jonbackflip/STM32-RFID-Based-Minecraft-Jukebox/PCB_Images/Bottom_Angled.png

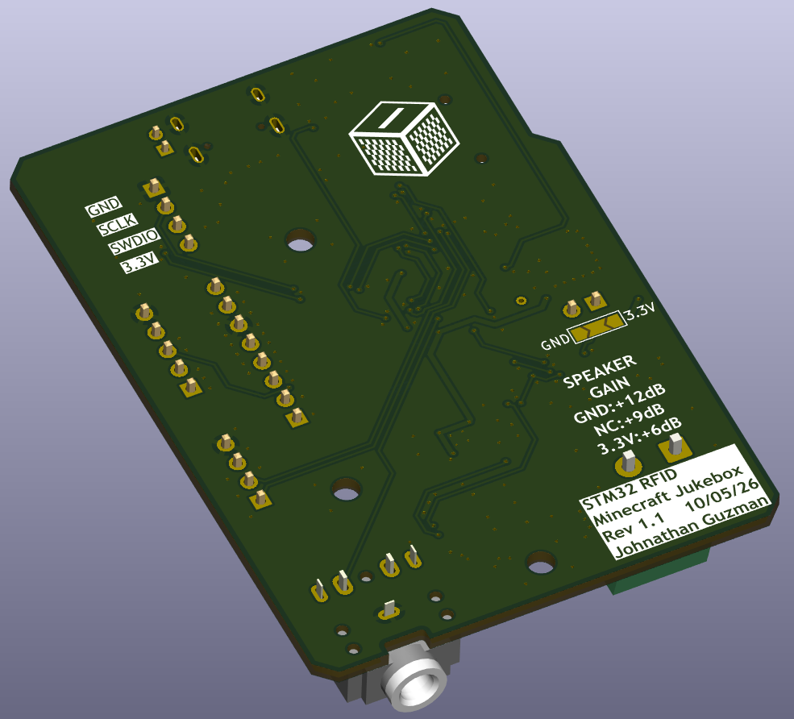
PCB_Images/Bottom_Angled.png
