jonbackflip/STM32-RFID-Based-Minecraft-Jukebox/PCB_Images/Top_Angled.png

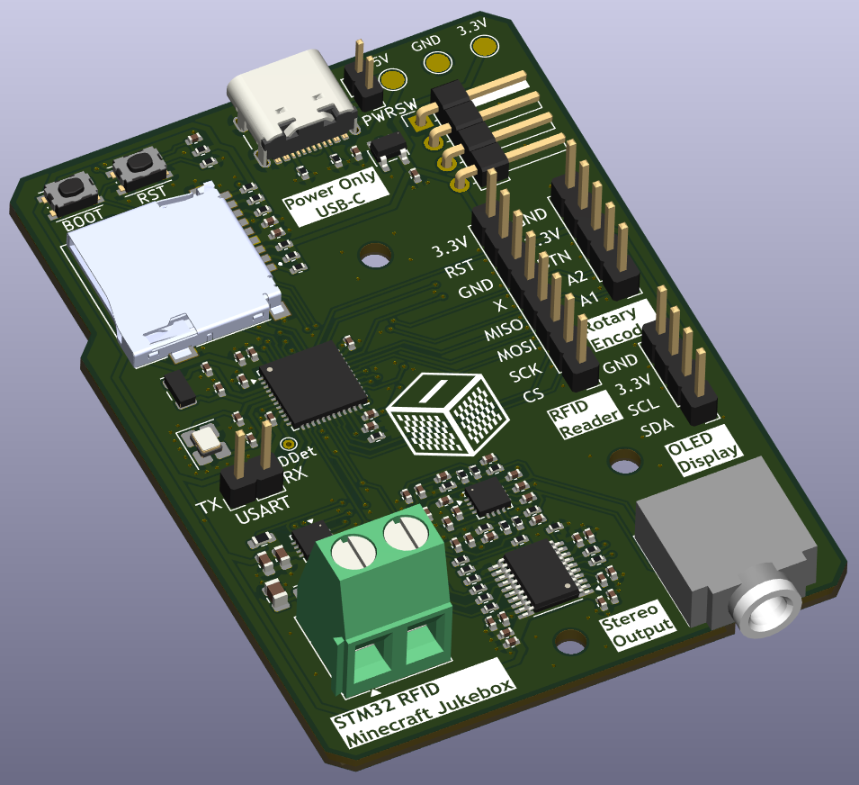
PCB_Images/Top_Angled.png
