jonbackflip/STM32-RFID-Based-Minecraft-Jukebox/README.md

# STM32-RFID-Based-Minecraft-Jukebox
An embedded music player based on the Minecraft Jukebox. Designed around an STM32F411CEU6, integrating RFID-based song selection, microSD storage, digital audio, user control via a rotary encoder with push-button, OLED display, and speaker/headphone output.
