jonbackflip/STM32-RFID-Based-Minecraft-Jukebox/PCB_Images/Bottom.png

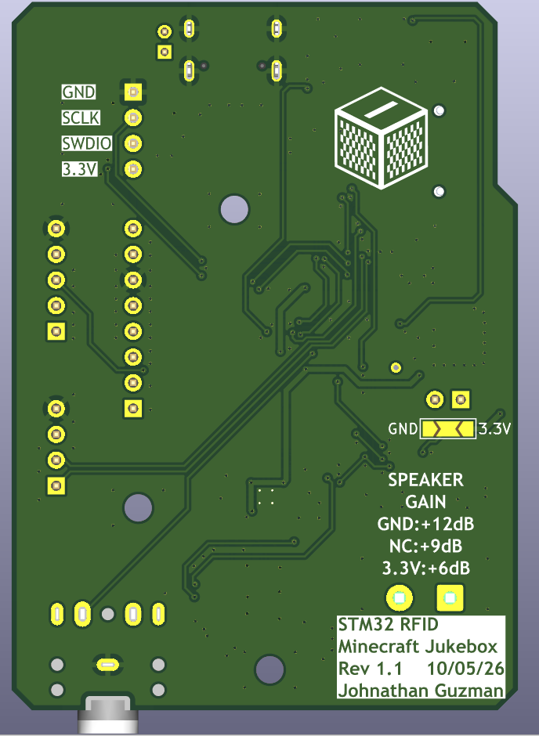
PCB_Images/Bottom.png
