jonbackflip/STM32-RFID-Based-Minecraft-Jukebox/PCB_Images/L1.png

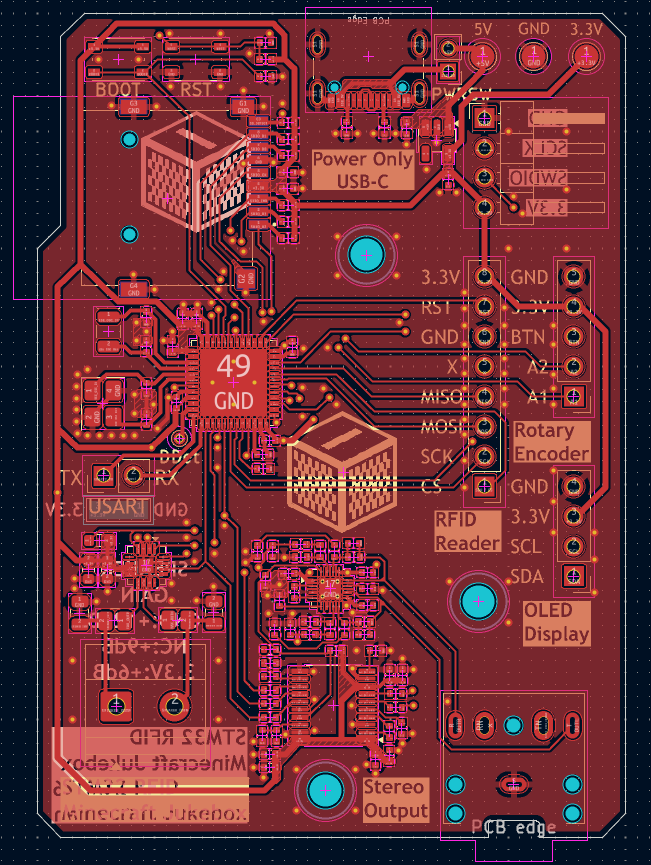
PCB_Images/L1.png
