jonbackflip/STM32-RFID-Based-Minecraft-Jukebox/PCB_Images/L2.png

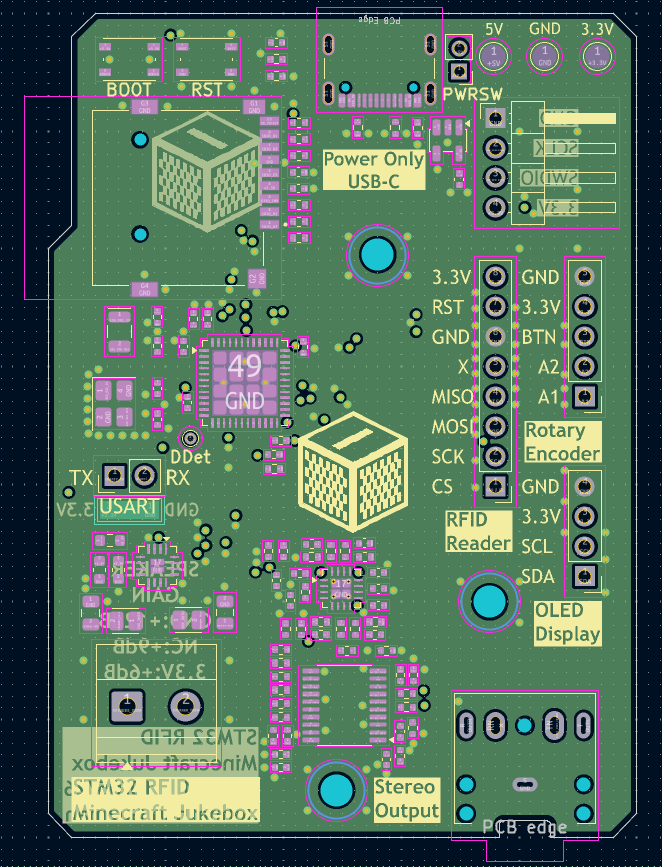
PCB_Images/L2.png
