jonbackflip/STM32-RFID-Based-Minecraft-Jukebox/PCB_Images/L3.png

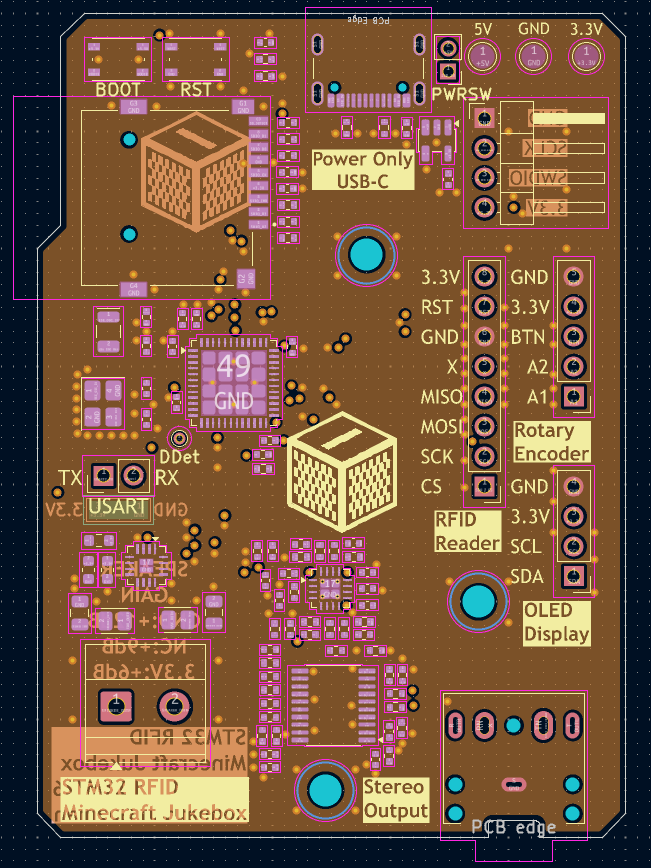
PCB_Images/L3.png
