jonbackflip/STM32-RFID-Based-Minecraft-Jukebox/PCB_Images/L4.png

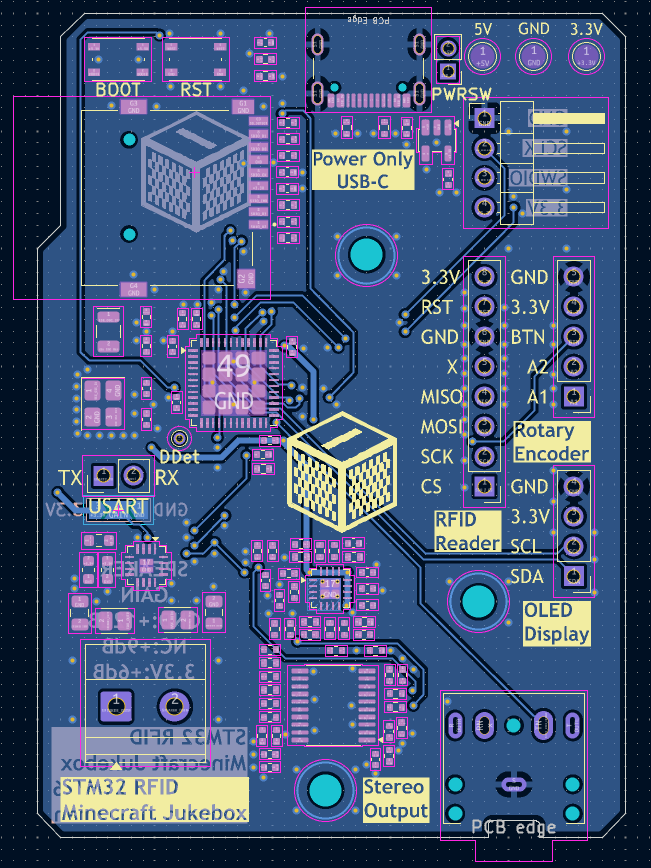
PCB_Images/L4.png
