jonbackflip/STM32-RFID-Based-Minecraft-Jukebox/PCB_Images/Top.png

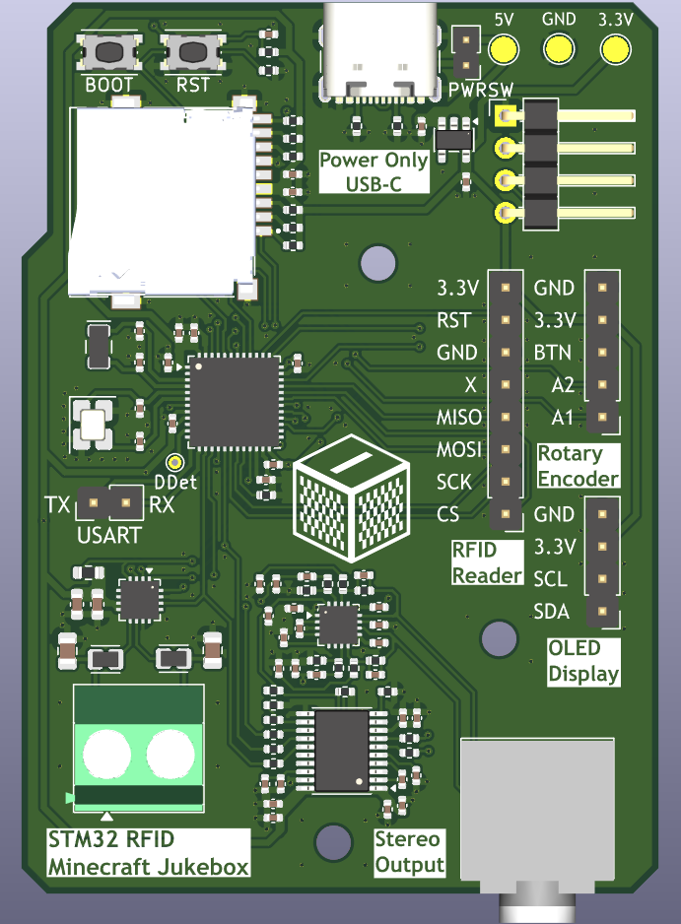
PCB_Images/Top.png
