jonbackflip/STM32-RFID-Based-Minecraft-Jukebox/Schematic_Images/Headphone DAC and Amplifier.png

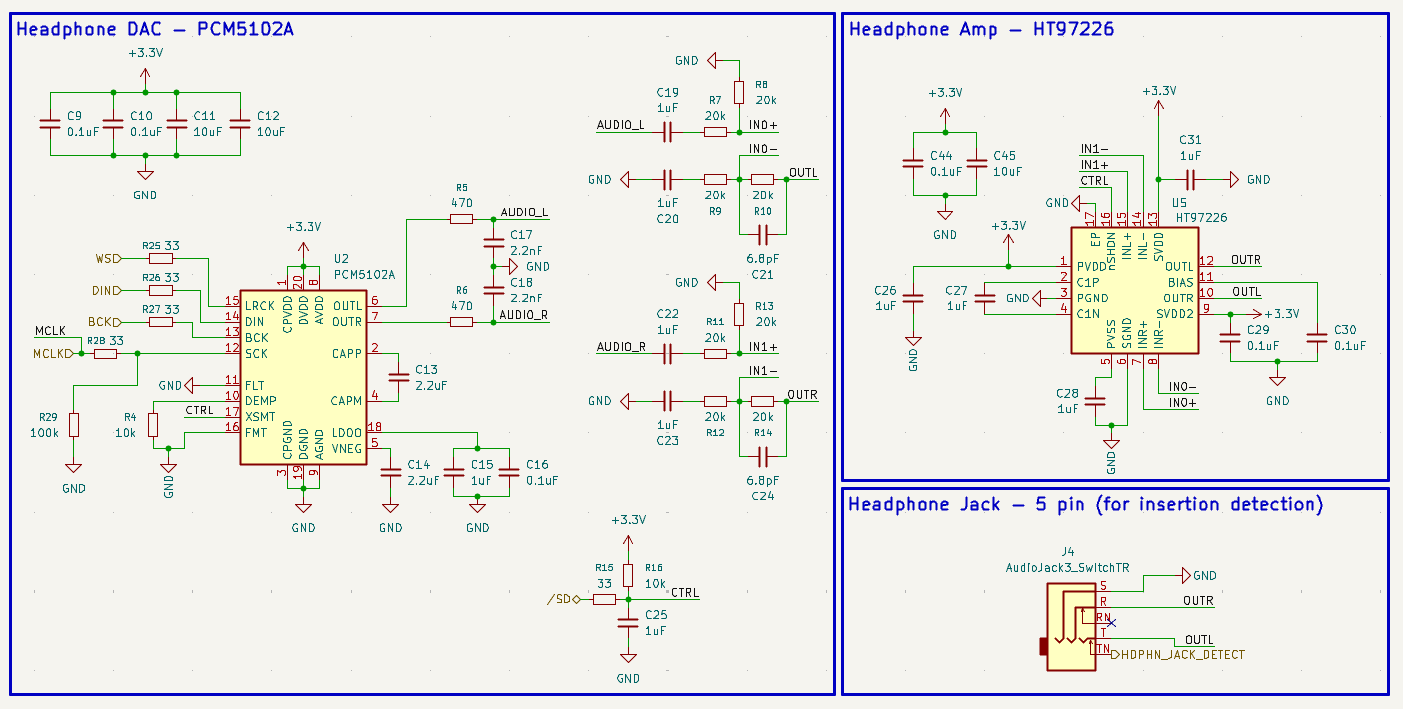
Schematic_Images/Headphone DAC and Amplifier.png
