jonbackflip/STM32-RFID-Based-Minecraft-Jukebox/Schematic_Images/High-Level Overview.png

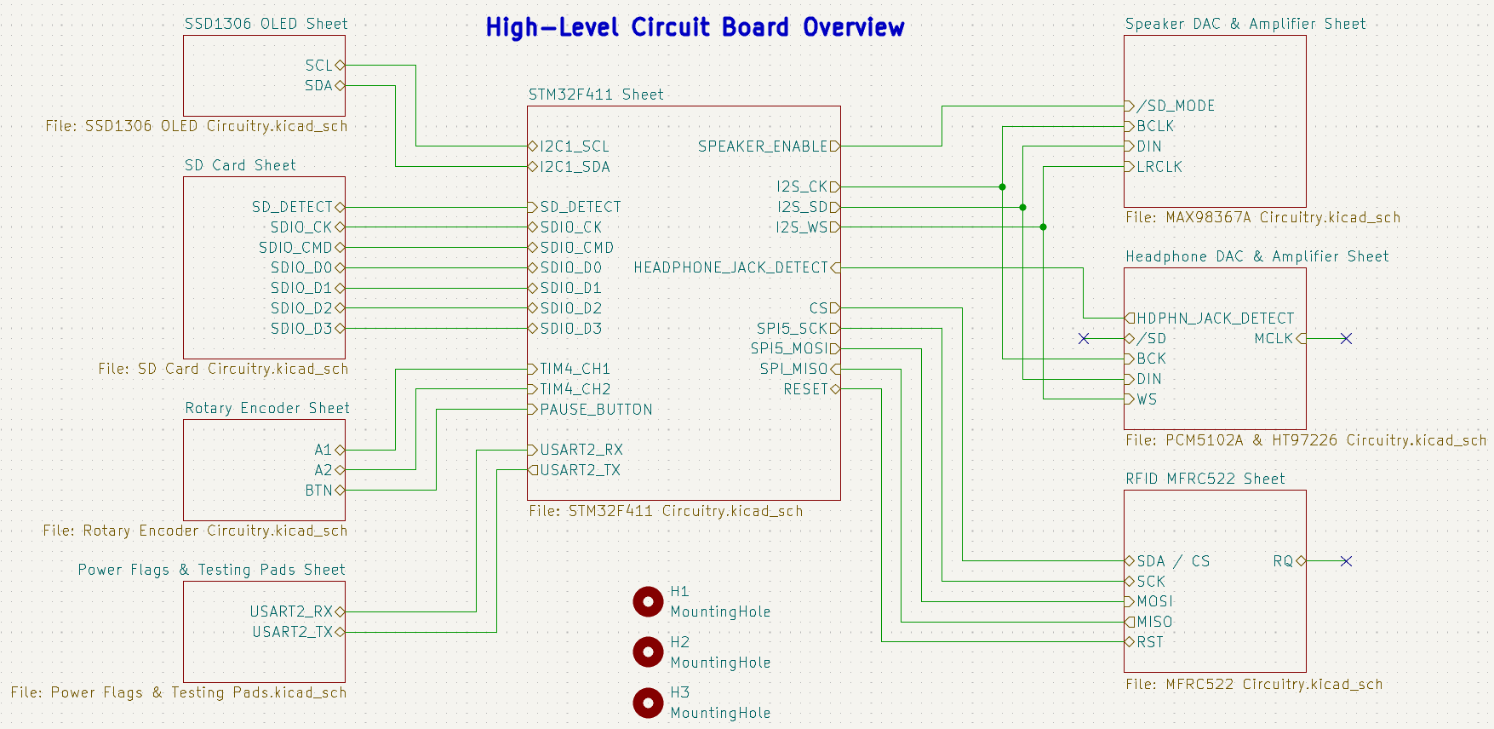
Schematic_Images/High-Level Overview.png
