jonbackflip/STM32-RFID-Based-Minecraft-Jukebox/Schematic_Images/MFRC522 RFID Reader.png

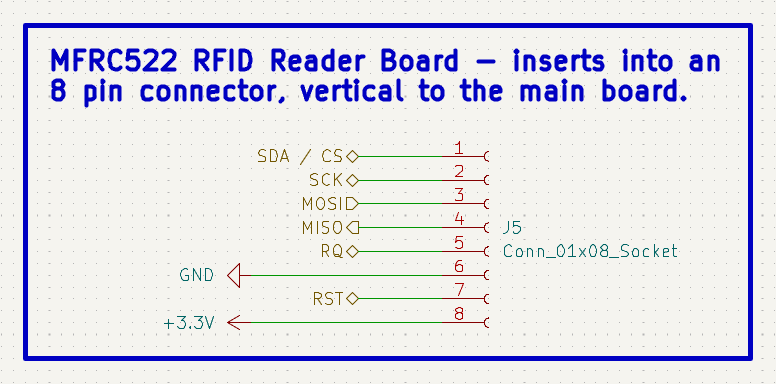
Schematic_Images/MFRC522 RFID Reader.png
