jonbackflip/STM32-RFID-Based-Minecraft-Jukebox/Schematic_Images/MicroSD Card.png

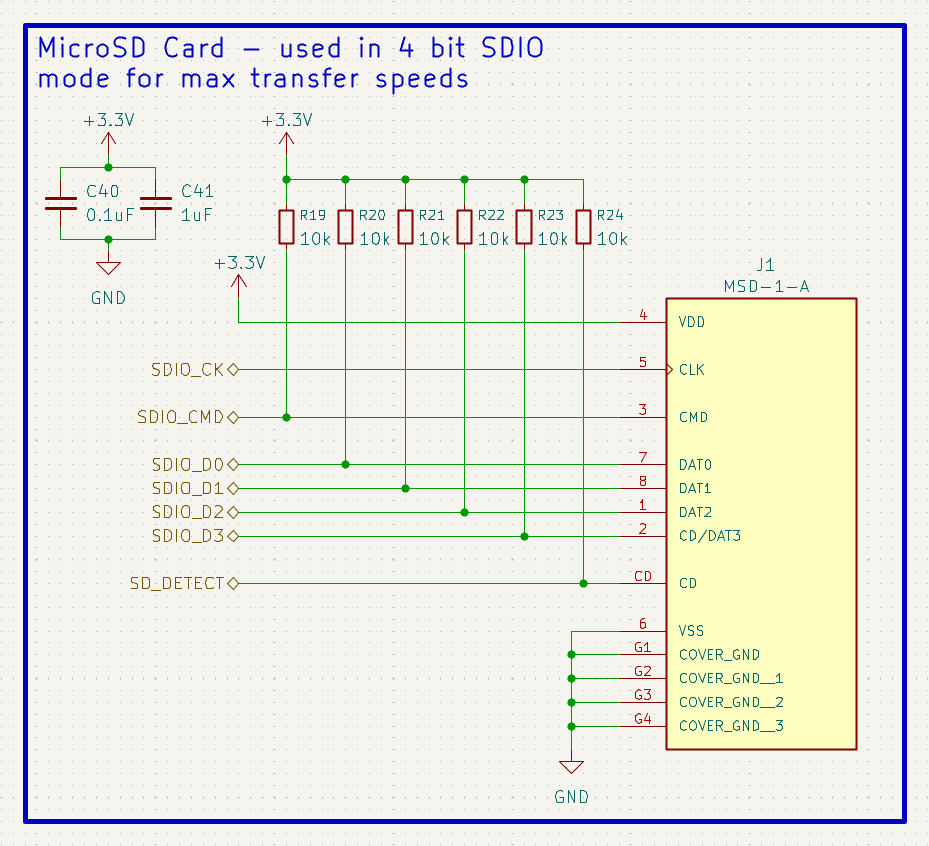
Schematic_Images/MicroSD Card.png
