jonbackflip/STM32-RFID-Based-Minecraft-Jukebox/Schematic_Images/Rotary Encoder.png

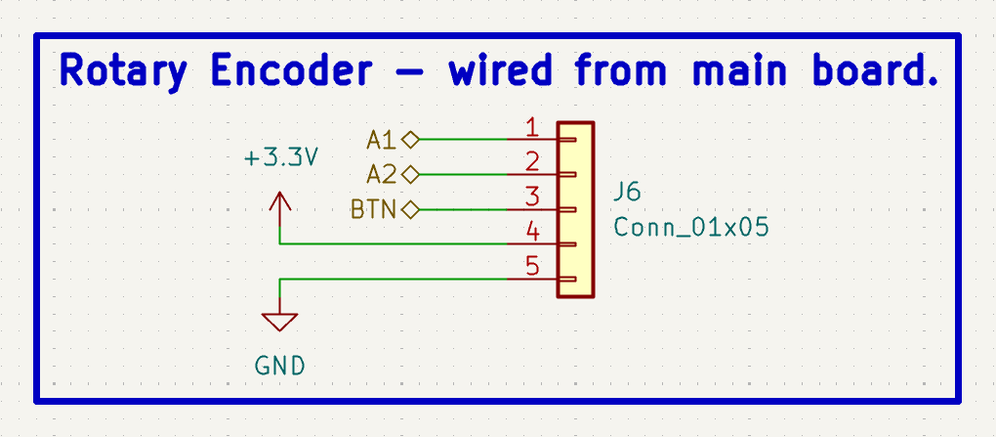
Schematic_Images/Rotary Encoder.png
