jonbackflip/STM32-RFID-Based-Minecraft-Jukebox/Schematic_Images/Speaker DAC and Amplifier.png

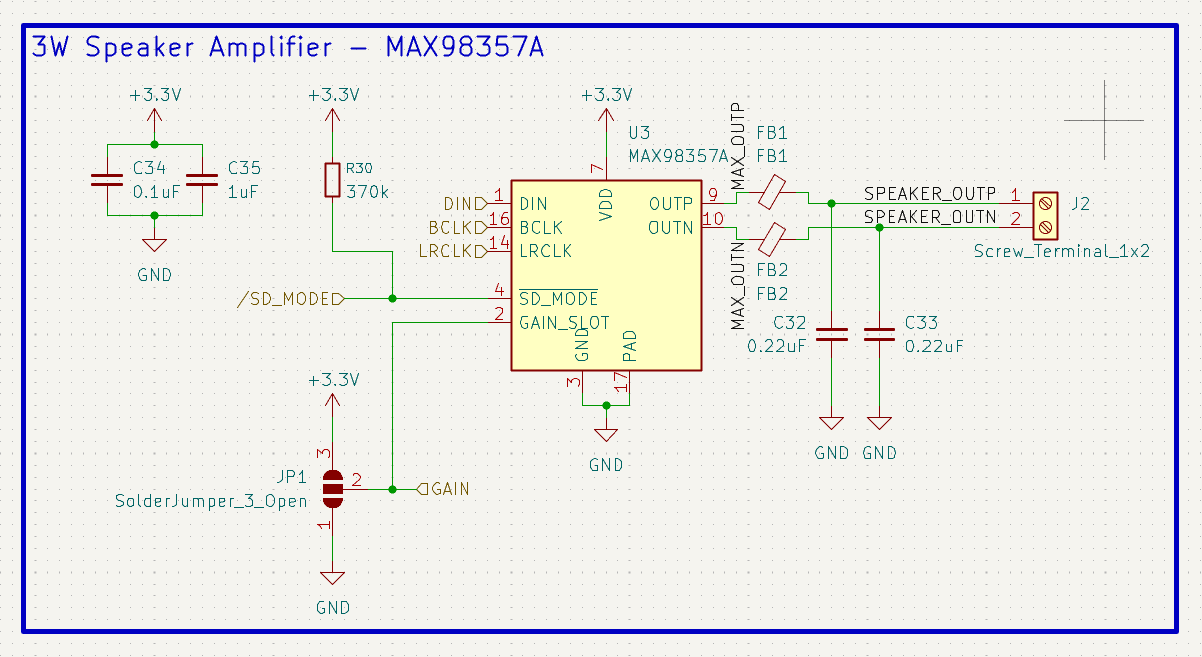
Schematic_Images/Speaker DAC and Amplifier.png
