jonbackflip/STM32-RFID-Based-Minecraft-Jukebox/Schematic_Images/SSD1306 OLED.png

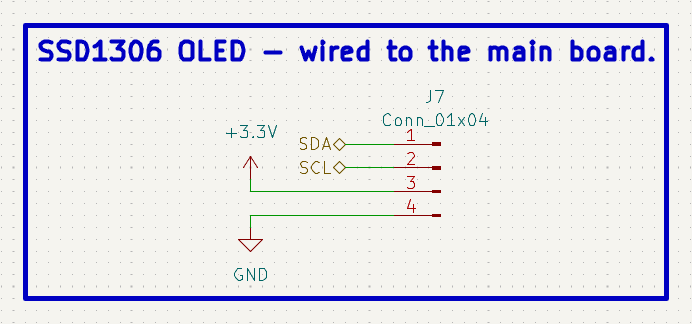
Schematic_Images/SSD1306 OLED.png
