jonbackflip/STM32-RFID-Based-Minecraft-Jukebox/Schematic_Images/STM32F411.png

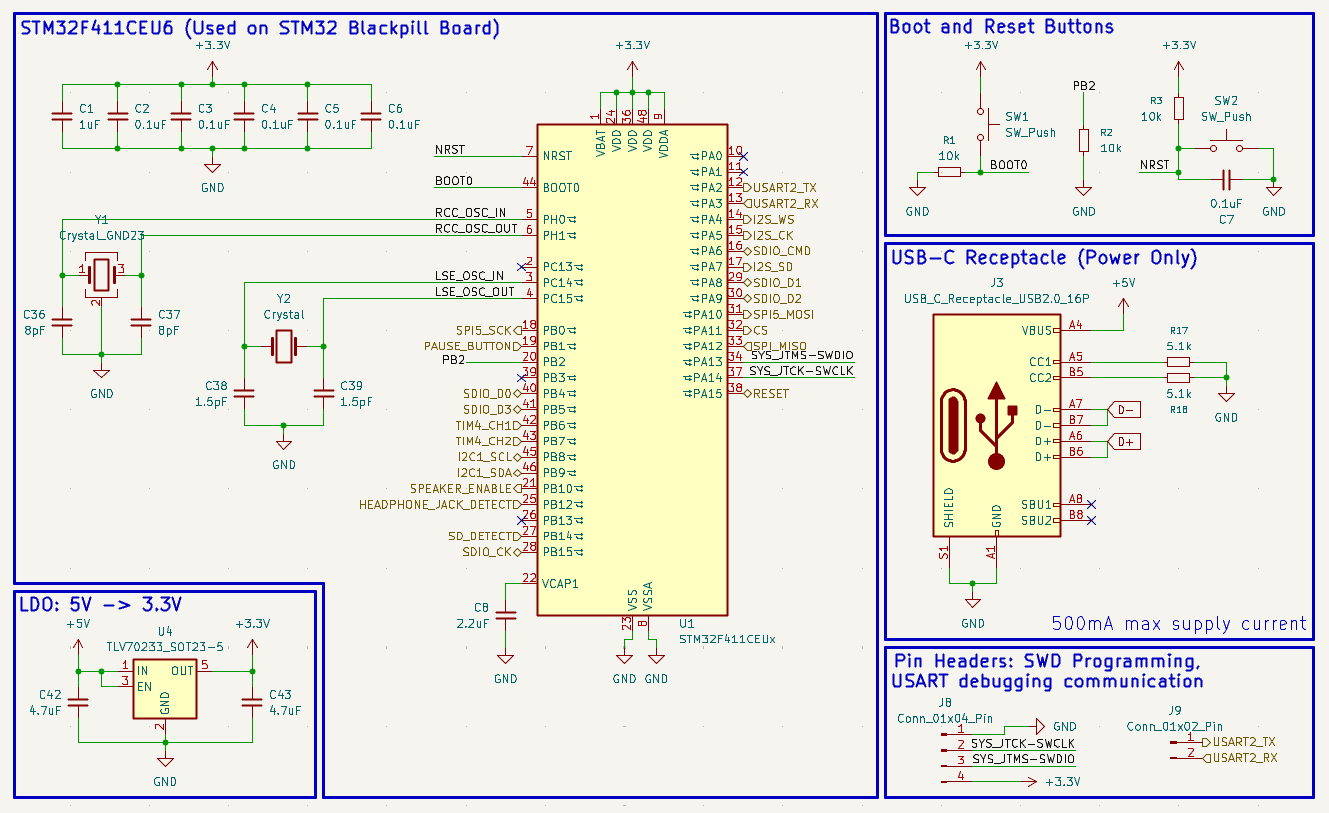
Schematic_Images/STM32F411.png
