jonbackflip/STM32-RFID-Based-Minecraft-Jukebox/Schematic_Images/Power Flags and Testing Points.png

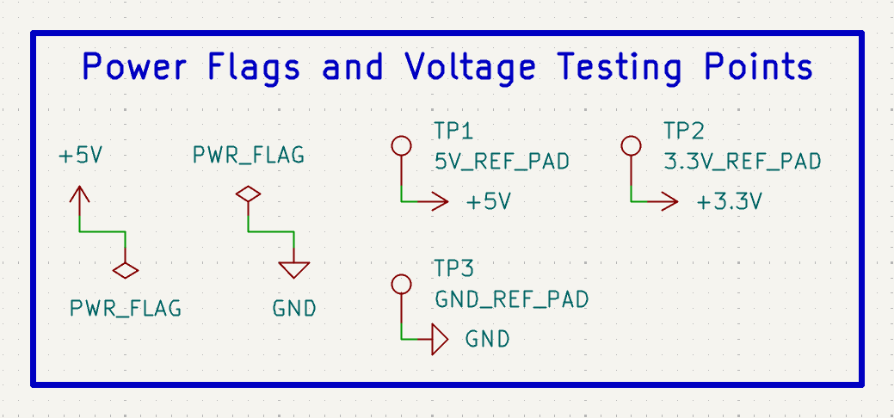
Schematic_Images/Power Flags and Testing Points.png
