jonbackflip/STM32-RFID-Based-Minecraft-Jukebox/STM32JukeboxPCB.kicad_pcb

## KiCad design STM32JukeboxPCB.kicad_pcb (2026-10-05)

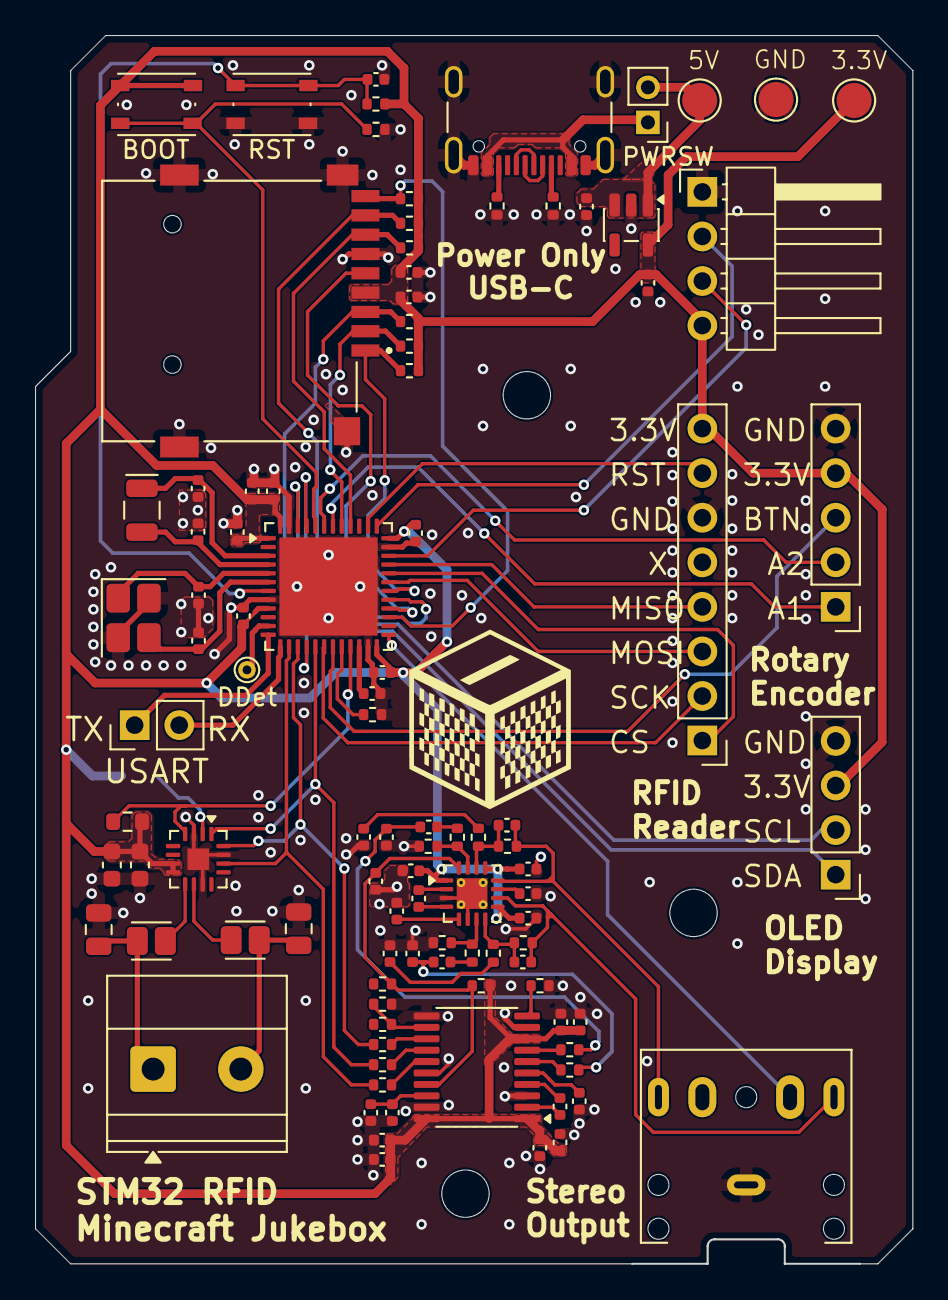
[picture p19: board STM32JukeboxPCB.kicad_pcb from above]

Board: 4 copper layers, 50.0 x 70.0 mm, 104 parts (1 on the bottom side), 76 nets.

Parts:
C1, C15, C19, C20, C22, C23, C25, C26, C27, C28, C31, C41: 1uF; C_0402_1005Metric
C2, C3, C4, C5, C6, C7, C9, C10, C16, C29, C30, C40, C44: 0.1uF; C_0402_1005Metric
C8, C13, C14: 2.2uF; C_0402_1005Metric
C11, C12, C45: 10uF; C_0402_1005Metric
C17, C18: 2.2nF; C_0402_1005Metric
C21, C24: 6.8pF; C_0402_1005Metric
C32, C33: 0.22uF; C_0805_2012Metric
C34: 0.1uF; C_0603_1608Metric
C35: 1uF; C_0603_1608Metric
C36, C37: 8pF; C_0402_1005Metric
C38, C39: 1.5pF; C_0402_1005Metric
C42, C43: 4.7uF; C_0402_1005Metric
DDet: Conn_1x1; TestPoint_THTPad_D1.0mm_Drill0.5mm
FB1: FB1; L_Eaton_MCL2012V1
FB2: FB2; L_Eaton_MCL2012V1
H1, H2, H3: MountingHole; MountingHole_2.7mm_M2.5_DIN965
J1: MSD-1-A; CUI_MSD-1-A
J2: Screw_Terminal_1x2; TerminalBlock_Phoenix_MKDS-1,5-2_1x02_P5.00mm_Horizontal
J3: USB_C_Receptacle_USB2.0_16P; USB_C_Receptacle_GCT_USB4105-xx-A_16P_TopMnt_Horizontal
J4: AudioJack3_SwitchTR; Jack_3.5mm_CUI_SJ1-3525N_Horizontal
J5: Conn_01x08_Socket; PinHeader_1x08_P2.54mm_Vertical
J6: Conn_01x05; PinHeader_1x05_P2.54mm_Vertical
J7: Conn_01x04; PinHeader_1x04_P2.54mm_Vertical
J8: Conn_01x04_Pin; PinHeader_1x04_P2.54mm_Horizontal
J9: Conn_01x02_Pin; PinHeader_1x02_P2.54mm_Vertical
JP1: SolderJumper_3_Open; SolderJumper-3_P2.0mm_Open_TrianglePad1.0x1.5mm_NumberLabels
PWRSW: SW_SPST; PinHeader_1x02_P2.00mm_Vertical
R1, R2, R3, R4, R16, R19, R20, R21, R22, R23, R24: 10k; R_0402_1005Metric
R5, R6: 470; R_0402_1005Metric
R7, R8, R9, R10, R11, R12, R13, R14: 20k; R_0402_1005Metric
R15, R25, R26, R27, R28: 33; R_0402_1005Metric
R17, R18: 5.1k; R_0402_1005Metric
R29: 100k; R_0402_1005Metric
R30: 370k; R_0603_1608Metric
SW1, SW2: SW_Push; SW_Push_1P1T_NO_Vertical_Wuerth_434133025816
TP1: 5V_REF_PAD; TestPoint_Pad_D2.0mm
TP2: 3.3V_REF_PAD; TestPoint_Pad_D2.0mm
TP3: GND_REF_PAD; TestPoint_Pad_D2.0mm
U1: STM32F411CEUx; QFN-48-1EP_7x7mm_P0.5mm_EP5.6x5.6mm
U2: PCM5102A; TSSOP-20_4.4x6.5mm_P0.65mm
U3: MAX98357A; TQFN-16-1EP_3x3mm_P0.5mm_EP1.23x1.23mm
U4: TLV70233_SOT23-5; SOT-23-5
U5: HT97226; QFN-16-1EP_3x3mm_P0.5mm_EP1.75x1.75mm_ThermalVias
Y1: Crystal_GND23; Oscillator_SMD_SeikoEpson_SG210-4Pin_2.5x2.0mm_HandSoldering
Y2: Crystal; Crystal_SMD_MicroCrystal_CC7V-T1A-2Pin_3.2x1.5mm

Connections:
+3.3V: C1.1, C2.1, C3.1, C4.1, C5.1, C6.1, C9.1, C10.1, C11.1, C12.1, C26.1, C29.1, C31.1, C34.1, C35.2, C40.1, C41.2, C43.1, C44.1, C45.1, J1.4 (VDD), J5.8, J6.4, J7.3, J8.4, JP1.3 (B), R3.2, R16.1, R19.2, R20.2, R21.2, R22.2, R23.2, R24.2, R30.2, SW1.1, TP2.1 (1_1), U1.1 (VBAT), U1.9 (VDDA), U1.24 (VDD), U1.36 (VDD), U1.48 (VDD), U2.1 (CPVDD), U2.8 (AVDD), U2.20 (DVDD), U3.7 (VDD), U3.8 (VDD), U4.5 (OUT), U5.1 (PVDD), U5.9 (SVDD2), U5.13 (SVDD)
+5V: C42.1, PWRSW.2 (B), TP1.1 (1_1), U4.1 (IN), U4.3 (EN)
/Headphone DAC & Amplifier Sheet/AUDIO_L: C17.1, C19.1, R5.1
/Headphone DAC & Amplifier Sheet/AUDIO_R: C18.2, C22.1, R6.1
/Headphone DAC & Amplifier Sheet/BCK: R27.2, U1.15 (PA5), U3.16 (BCLK)
/Headphone DAC & Amplifier Sheet/CTRL: C25.1, R15.1, R16.2, U2.17 (XSMT), U5.16 (nSHDN)
/Headphone DAC & Amplifier Sheet/DIN: R26.2, U1.17 (PA7), U3.1 (DIN)
/Headphone DAC & Amplifier Sheet/HDPHN_JACK_DETECT: J4.TN, U1.25 (PB12)
/Headphone DAC & Amplifier Sheet/IN0+: R7.1, R8.2, U5.7 (INR+)
/Headphone DAC & Amplifier Sheet/IN0-: C21.1, R9.1, R10.2, U5.8 (INR-)
/Headphone DAC & Amplifier Sheet/IN1+: R11.1, R13.2, U5.15 (INL+)
/Headphone DAC & Amplifier Sheet/IN1-: C24.1, R12.1, R14.2, U5.14 (INL-)
/Headphone DAC & Amplifier Sheet/OUTL: C21.2, J4.T, R10.1, U5.10 (OUTR)
/Headphone DAC & Amplifier Sheet/OUTR: C24.2, J4.R, R14.1, U5.12 (OUTL)
/Headphone DAC & Amplifier Sheet/WS: R25.2, U1.14 (PA4), U3.14 (LRCLK)
/RFID MFRC522 Sheet/MISO: J5.4, U1.33 (PA12)
/RFID MFRC522 Sheet/MOSI: J5.3, U1.31 (PA10)
/RFID MFRC522 Sheet/RST: J5.7, U1.38 (PA15)
/RFID MFRC522 Sheet/SCK: J5.2, U1.18 (PB0)
/RFID MFRC522 Sheet/SDA / CS: J5.1, U1.32 (PA11)
/Rotary Encoder Sheet/A1: J6.1, U1.42 (PB6)
/Rotary Encoder Sheet/A2: J6.2, U1.43 (PB7)
/Rotary Encoder Sheet/BTN: J6.3, U1.19 (PB1)
/SD Card Sheet/SDIO_CK: J1.5 (CLK), U1.28 (PB15)
/SD Card Sheet/SDIO_CMD: J1.3 (CMD), R19.1, U1.16 (PA6)
/SD Card Sheet/SDIO_D0: J1.7 (DAT0), R20.1, U1.40 (PB4)
/SD Card Sheet/SDIO_D1: J1.8 (DAT1), R21.1, U1.29 (PA8)
/SD Card Sheet/SDIO_D2: J1.1 (DAT2), R22.1, U1.30 (PA9)
/SD Card Sheet/SDIO_D3: J1.2 (CD/DAT3), R23.1, U1.41 (PB5)
/SD Card Sheet/SD_DETECT: J1.CD, R24.1, U1.27 (PB14)
/SSD1306 OLED Sheet/SCL: J7.2, U1.45 (PB8)
/SSD1306 OLED Sheet/SDA: J7.1, U1.46 (PB9)
/STM32F411 Sheet/BOOT0: R1.2, SW1.2, U1.44 (BOOT0)
/STM32F411 Sheet/Insert_Disc_Detect: DDet.1 (Pin_1_1), U1.11 (PA1)
/STM32F411 Sheet/LSE_OSC_IN: C38.1, U1.3 (PC14), Y2.1
/STM32F411 Sheet/LSE_OSC_OUT: C39.1, U1.4 (PC15), Y2.2
/STM32F411 Sheet/NRST: C7.1, R3.1, SW2.1, U1.7 (NRST)
/STM32F411 Sheet/PB2: R2.2, U1.20 (PB2)
/STM32F411 Sheet/RCC_OSC_IN: C36.1, U1.5 (PH0), Y1.1
/STM32F411 Sheet/RCC_OSC_OUT: C37.1, U1.6 (PH1), Y1.3
/STM32F411 Sheet/SPEAKER_ENABLE: R30.1, U1.21 (PB10), U3.4 (~SD_MODE)
/STM32F411 Sheet/SYS_JTCK-SWCLK: J8.2, U1.37 (PA14)
/STM32F411 Sheet/SYS_JTMS-SWDIO: J8.3, U1.34 (PA13)
/STM32F411 Sheet/USART2_RX: J9.2, U1.13 (PA3)
/STM32F411 Sheet/USART2_TX: J9.1, U1.12 (PA2)
/STM32F411 Sheet/USB_5V: J3.A4 (VBUS), J3.A9 (VBUS), J3.B4 (VBUS), J3.B9 (VBUS), PWRSW.1 (A)
/Speaker DAC & Amplifier Sheet/GAIN: JP1.2 (C), U3.2 (GAIN_SLOT)
/Speaker DAC & Amplifier Sheet/MAX_OUTN: FB2.1, U3.10 (OUTN)
/Speaker DAC & Amplifier Sheet/MAX_OUTP: FB1.1, U3.9 (OUTP)
/Speaker DAC & Amplifier Sheet/SPEAKER_OUTN: C33.1, FB2.2, J2.2
/Speaker DAC & Amplifier Sheet/SPEAKER_OUTP: C32.2, FB1.2, J2.1
D+: J3.A6 (D+), J3.B6 (D+)
D-: J3.A7 (D-), J3.B7 (D-)
GND: C1.2, C2.2, C3.2, C4.2, C5.2, C6.2, C7.2, C8.2, C9.2, C10.2, C11.2, C12.2, C14.2, C15.2, C16.2, C17.2, C18.1, C20.1, C23.1, C25.2, C26.2, C28.2, C29.2, C30.2, C31.2, C32.1, C33.2, C34.2, C35.1, C36.2, C37.2, C38.2, C39.2, C40.2, C41.1, C42.2, C43.2, C44.2, C45.2, J1.6 (VSS), J1.G1 (COVER_GND), J1.G2 (COVER_GND__1), J1.G3 (COVER_GND__2), J1.G4 (COVER_GND__3), J3.A1 (GND), J3.A12 (GND), J3.B1 (GND), J3.B12 (GND), J3.S1 (SHIELD), J4.S, J5.6, J6.5, J7.4, J8.1, JP1.1 (A), R1.1, R2.1, R4.1, R8.1, R13.1, R17.1, R18.1, R29.2, SW2.2, TP3.1 (1_1), U1.8 (VSSA), U1.23 (VSS), U1.35 (VSS), U1.47 (VSS), U1.49 (VSS), U2.3 (CPGND), U2.9 (AGND), U2.11 (FLT), U2.16 (FMT), U2.19 (DGND), U3.3 (GND), U3.11 (GND), U3.15 (GND), U3.17 (PAD), U4.2 (GND), U5.3 (PGND), U5.6 (SGND), U5.17 (EP), Y1.2 (G), Y1.4 (G)
unnamed: C19.2, R7.2
unnamed: C20.2, R9.2
unnamed: C22.2, R11.2
unnamed: C23.2, R12.2
unnamed: J3.A5 (CC1), R17.2
unnamed: J3.B5 (CC2), R18.2
unnamed: C8.1, U1.22 (VCAP1)
unnamed: R27.1, U2.13 (BCK)
unnamed: C13.2, U2.4 (CAPM)
unnamed: C13.1, U2.2 (CAPP)
unnamed: R4.2, U2.10 (DEMP)
unnamed: R26.1, U2.14 (DIN)
unnamed: C15.1, C16.1, U2.18 (LDOO)
unnamed: R25.1, U2.15 (LRCK)
unnamed: R5.2, U2.6 (OUTL)
unnamed: R6.2, U2.7 (OUTR)
unnamed: R28.1, R29.1, U2.12 (SCK)
unnamed: C14.1, U2.5 (VNEG)
unnamed: C30.1, U5.11 (BIAS)
unnamed: C27.2, U5.4 (C1N)
unnamed: C27.1, U5.2 (C1P)
unnamed: C28.1, U5.5 (PVSS)
