jonbackflip/STM32-RFID-Based-Minecraft-Jukebox/Jukebox_STM32CubeIDE_Files/Core/Src/main.c

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
/* Includes ------------------------------------------------------------------*/
#include "main.h"
#include "fatfs.h"

/* USER CODE BEGIN Includes */
#include <string.h>
#include "SSD1306Driver.h"
#include "MFRC522_STM32.h"
#include "WavPlayer.h"
/* USER CODE END Includes */

/* USER CODE BEGIN PD */

#define TAU 6.28318530717958647692

/* USER CODE END PD */

I2C_HandleTypeDef hi2c1;

I2S_HandleTypeDef hi2s1;
DMA_HandleTypeDef hdma_spi1_tx;

SD_HandleTypeDef hsd;
DMA_HandleTypeDef hdma_sdio;

SPI_HandleTypeDef hspi5;

TIM_HandleTypeDef htim1;
TIM_HandleTypeDef htim2;
TIM_HandleTypeDef htim4;

UART_HandleTypeDef huart2;

/* USER CODE BEGIN PV */

// ---- OLED redraw throttle (set by TIM2 ISR, checked once per main loop) --
volatile uint8_t oledNeedsRedraw = 0;

// ---- Idle-screen animation (jukebox icon + flashing arrow) --------------
// Toggled every TIM2 tick (250ms) -> 2Hz blinking rate
static volatile uint8_t arrowBlinkOn = 0;

// ---- RFID detection, triggered by the disc-press button on PA1 ----------
// The button's EXTI ISR only arms a burst -- it must NOT call
// MFRC522_RequestA() itself (each call can block tens of ms; 8 of them
// back-to-back inside an interrupt could stall I2S refills for most of
// a second). The main loop steps the burst one poll at a time, 100ms
// apart, same timing discipline as the old continuous TIM1 poll.
#define RFID_BURST_POLL_COUNT      4   // total polls per button press
#define RFID_BURST_CONFIRM_COUNT   1   // need at least this many "present" results
#define RFID_POLL_INTERVAL_MS      100 // spacing between polls within a burst
#define BUTTON_DEBOUNCE_MS         300 // ignore re-triggers faster than this

typedef enum { RFID_BURST_IDLE, RFID_BURST_ACTIVE } RfidBurstState_t;
static volatile RfidBurstState_t burstState = RFID_BURST_IDLE; // set by EXTI ISR, cleared by main loop
static uint32_t burstLastPollTime = 0;
static uint8_t  burstPollsRemaining = 0;
static uint8_t  burstGoodCount = 0;
static uint32_t lastButtonEventTime = 0;

typedef enum { DISC_ABSENT, DISC_PRESENT } DiscState_t;
static DiscState_t discState = DISC_ABSENT;

// ---- UI polling (volume pot, pause button, headphone jack) --------------
#define UI_POLL_INTERVAL_MS 20
static uint32_t uiLastPoll = 0;
static volatile uint8_t volumePercent = 100;
static uint8_t headphoneConnected = 0;
static uint8_t pauseButtonWasDown = 0;

// ---- Song table: RFID UID -> WAV file on the SD card ---------------------
// Add one entry per tag. Filenames are LFN paths
typedef struct {
    uint8_t uid[4];
    const char *filePath;
} SongEntry_t;

static const SongEntry_t songTable[] = {
	{ {0xD0, 0xF6, 0xFF, 0x5C}, "Alpha.WAV" },
    { {0x10, 0x27, 0x00, 0x56}, "Cat.WAV" },
	{ {0xD0, 0x8A, 0x78, 0x5C}, "Blocks.WAV" },
	{ {0xC7, 0x6D, 0x8D, 0x64}, "Chirp.WAV"  },
	{ {0xD0, 0x3B, 0x70, 0x5C}, "Far.WAV"  },
	{ {0x21, 0x56, 0x62, 0x64}, "Mall.WAV"  },
	{ {0xD0, 0xE6, 0x7C, 0x5C}, "Mellohi.WAV" },
	{ {0x21, 0x73, 0x3A, 0x64}, "Stal.WAV" },
	{ {0xE0, 0x5B, 0x7D, 0x5C}, "Strad.WAV" },
	{ {0xD0, 0xE6, 0x6A, 0x5C}, "Ward.WAV" },
	{ {0x00, 0x17, 0x1A, 0x56}, "Wait.WAV" },
	{ {0xC0, 0xD9, 0x2F, 0x5C}, "Pigstep.WAV" },
	{ {0x71, 0x9B, 0x3E, 0x6E}, "Otherside.WAV" },
	{ {0xD0, 0x92, 0xA2, 0x5C}, "Relic.WAV" },
	{ {0x10, 0x0C, 0x10, 0x56}, "Melonkale.WAV" },
};
#define SONG_TABLE_COUNT (sizeof(songTable) / sizeof(songTable[0]))

static const SongEntry_t *find_song_by_uid(const uint8_t *uid)
{
    for (uint32_t i = 0; i < SONG_TABLE_COUNT; i++)
        if (memcmp(songTable[i].uid, uid, 4) == 0)
            return &songTable[i];
    return NULL;
}

/* USER CODE END PV */

void SystemClock_Config(void);
static void MX_GPIO_Init(void);
static void MX_DMA_Init(void);
static void MX_I2S1_Init(void);
static void MX_SDIO_SD_Init(void);
static void MX_SPI5_Init(void);
static void MX_I2C1_Init(void);
static void MX_USART2_UART_Init(void);
static void MX_TIM1_Init(void);
static void MX_TIM2_Init(void);
static void MX_TIM4_Init(void);
/* USER CODE BEGIN 0 */
int _write(int fd, unsigned char *buf, int len) {
  if (fd == 1 || fd == 2) {                     // stdout or stderr ?
    HAL_UART_Transmit(&huart2, buf, len, HAL_MAX_DELAY);  // Print to the UART
  }
  return len;
}

uint8_t uid[4];
MFRC522_t rfID = {&hspi5, CS_GPIO_Port, CS_Pin, RESET_GPIO_Port, RESET_Pin};
WavPlayer_t player;

static void RFID_BurstStep(MFRC522_t *dev, WavPlayer_t *wp);
static void UI_Poll(WavPlayer_t *wp);
static void OLED_Redraw(WavPlayer_t *wp);

/* USER CODE END 0 */

/**
  * @brief  The application entry point.
  * @retval int
  */
int main(void)
{

  /* MCU Configuration--------------------------------------------------------*/

  /* Reset of all peripherals, Initializes the Flash interface and the Systick. */
  HAL_Init();

  /* Configure the system clock */
  SystemClock_Config();

  /* Initialize all configured peripherals */
  MX_GPIO_Init();
  MX_DMA_Init();
  MX_I2S1_Init();
  MX_SDIO_SD_Init();
  MX_SPI5_Init();
  MX_I2C1_Init();
  MX_USART2_UART_Init();
  MX_FATFS_Init();
  MX_TIM1_Init();
  MX_TIM2_Init();
  MX_TIM4_Init();
  /* USER CODE BEGIN 2 */

  // HAL_TIM_Base_Start_IT(&htim1);
  HAL_TIM_Base_Start_IT(&htim2);
  HAL_TIM_Encoder_Start(&htim4, TIM_CHANNEL_ALL);
  __HAL_TIM_ENABLE_IT(&htim4, TIM_IT_UPDATE);

  ssd1306_init();

  MFRC522_Init(&rfID);

  WavPlayer_Init(&player);
  WavPlayer_SetVolume(volumePercent);

  FRESULT mountResult = f_mount(&SDFatFS, SDPath, 1); // 1 = mount now
  if (mountResult != FR_OK)
  {
      printf("SD mount failed: FRESULT=%d\r\n", mountResult);
      Error_Handler();
  }
  printf("SD mounted OK\r\n");


  printf("\n\n\n---------------------\nStarting jukebox\n");

  /* USER CODE END 2 */

  /* Infinite loop */
  /* USER CODE BEGIN WHILE */
  while (1)
  {
	  // 1. I2s DMA feed is of HIGHEST PRIORITY
	  WavPlayer_Poll(&player);

	  if (WavPlayer_IsFinished(&player))
	  {
		  WavPlayer_Stop(&player); // record's done -- go quiet until next tag
	  }

	  // 2. UI peripherals -- encoder volume, encoder pause button, headphone jack.
	  // Polled every 20ms
	  UI_Poll(&player);

	  // 3. RFID -- a DISC-PRESS on PA1 sets the RFID_BURST_ACTIVE flag
	  //    and starts an 8-poll burst (see HAL_GPIO_EXTI_Callback);
	  //    RFID_BurstStep() advances it one poll per 100ms.
	  //    Immediately returns if the RFID_BURST_ACTIVE flag is not set.
	  RFID_BurstStep(&rfID, &player);

	  // 4. OLED -- updated every 250ms by flag set by the TIM2 ISR,
	  //    not redrawn every single pass.
	  if (oledNeedsRedraw)
	  {
		  oledNeedsRedraw = 0;
		  OLED_Redraw(&player);
	  }



    /* USER CODE END WHILE */

    /* USER CODE BEGIN 3 */
  }
  /* USER CODE END 3 */
}

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
/* USER CODE BEGIN 4 */

/*
void HAL_I2C_MasterTxCpltCallback(I2C_HandleTypeDef *hi2c)
{
    if (hi2c->Instance == I2C1)
    {
        ssd1306_dma_tx_complete();
    }
}
*/

void HAL_TIM_PeriodElapsedCallback(TIM_HandleTypeDef *htim)
{
	if (htim->Instance == TIM2)
    {
        oledNeedsRedraw = 1;
        arrowBlinkOn = ! arrowBlinkOn;
    }
    else if (htim->Instance == TIM4)
        {
		// Counter just overflowed (CW click) or underflowed (CCW click).
		// __HAL_TIM_IS_TIM_COUNTING_DOWN reads CR1's DIR bit, which
		// reflects the direction of the count that triggered this
		// update event.
		if (__HAL_TIM_IS_TIM_COUNTING_DOWN(htim))
		{
			volumePercent = (volumePercent >= 5) ? (volumePercent - 5) : 0;
		}
		else
		{
			volumePercent = (volumePercent <= 95) ? (volumePercent + 5) : 100;
		}
		WavPlayer_SetVolume(volumePercent);
        }
}

// Fires on the disc-press button's falling edge (PA1). Deliberately does
// nothing but set the burst flag (to keep this ISR short).
void HAL_GPIO_EXTI_Callback(uint16_t GPIO_Pin)
{
    if (GPIO_Pin == GPIO_PIN_1)
    {
        uint32_t now = HAL_GetTick();

        // Ignore re-triggers from switch bounce, and ignore a new press
        // while a burst from a previous press is still in progress.
        if (burstState == RFID_BURST_IDLE && (now - lastButtonEventTime) >= BUTTON_DEBOUNCE_MS)
        {
            lastButtonEventTime = now;
            burstPollsRemaining = RFID_BURST_POLL_COUNT;
            burstGoodCount = 0;
            burstLastPollTime = now; // first poll fires ~100ms from now, in the main loop
            burstState = RFID_BURST_ACTIVE;
        }
    }
}

// Call every main-loop pass. Does NOTHING UNLESS a burst is active AND
// 100ms have passed since the last poll within that burst -- so each
// individual (potentially slow) MFRC522_RequestA() call is still spaced
// out exactly like the old continuous polling was (100ms), just bounded
// to 8 calls per button press instead of running forever.
static void RFID_BurstStep(MFRC522_t *dev, WavPlayer_t *wp)
{
    if (burstState != RFID_BURST_ACTIVE) return;

    uint32_t now = HAL_GetTick();
    if ((now - burstLastPollTime) < RFID_POLL_INTERVAL_MS) return;
    burstLastPollTime = now;

    uint8_t localAtqa[2];
    if (MFRC522_RequestA(dev, localAtqa) == STATUS_OK)
    {
        burstGoodCount++;
    }
    burstPollsRemaining--;

    if (burstPollsRemaining > 0) return; // burst still in progress

    // Burst complete -- decide what the button press meant based on
    // whether a disc was already considered present.
    burstState = RFID_BURST_IDLE;
    uint8_t discDetected = (burstGoodCount >= RFID_BURST_CONFIRM_COUNT);
    USER_LOG("Burst result: %u/%u detected", burstGoodCount, RFID_BURST_POLL_COUNT);

    if (discState == DISC_ABSENT)
    {
        if (!discDetected)
        {
            USER_LOG("Insert not confirmed -- press again");
            return;
        }

        if (MFRC522_ReadUid(dev, uid) == STATUS_OK)
        {
            USER_LOG("CARD ID:%02X %02X %02X %02X", uid[0], uid[1], uid[2], uid[3]);

            const SongEntry_t *song = find_song_by_uid(uid);
            if (song)
            {
                USER_LOG("Playing %s", song->filePath);
                if (WavPlayer_Play(wp, song->filePath) != 0)
                {
                    USER_LOG("Failed to open/parse WAV file");
                }
            }
            else
            {
                USER_LOG("Unknown tag -- no song mapped");
            }
        }
        discState = DISC_PRESENT;
    }
    else // DISC_PRESENT
    {
        if (discDetected)
        {
            USER_LOG("Still detected -- removal not confirmed");
            return;
        }

        USER_LOG("Removal confirmed");
        WavPlayer_Stop(wp);
        discState = DISC_ABSENT;
    }
}


static void UI_Poll(WavPlayer_t *wp)
{
    uint32_t now = HAL_GetTick();
    if ((now - uiLastPoll) < UI_POLL_INTERVAL_MS) return;
    uiLastPoll = now;

    // Headphone jack detect
    // Active-low switch (grounds the pin when a plug seats).
    uint8_t hpNow = (HAL_GPIO_ReadPin(HEADPHONE_JACK_DETECT_GPIO_Port,
                                       HEADPHONE_JACK_DETECT_Pin) == GPIO_PIN_RESET);
    if (hpNow != headphoneConnected)
    {
        headphoneConnected = hpNow;
        // Mute/enable the speaker amp via its shutdown pin.
        HAL_GPIO_WritePin(SPEAKER_ENABLE_GPIO_Port, SPEAKER_ENABLE_Pin, headphoneConnected ? GPIO_PIN_RESET : GPIO_PIN_SET);
        headphoneConnected ? USER_LOG("Headphones connected") : USER_LOG("Headphones removed");
    }

    // Pause/unpause button
    // Active-low with internal pull-up. The 20ms poll gate
    // above already acts as a debounce for the encoder button.
    uint8_t btnNow = (HAL_GPIO_ReadPin(PAUSE_BTN_GPIO_Port, PAUSE_BTN_Pin) == GPIO_PIN_RESET);
    if (btnNow && !pauseButtonWasDown) // falling edge
    {
        if (wp->state == WAV_PLAYING) WavPlayer_Pause(wp);
        else if (wp->state == WAV_PAUSED) WavPlayer_Resume(wp);
    }
    pauseButtonWasDown = btnNow;
}

static void OLED_Redraw(WavPlayer_t *wp)
{
    ssd1306_clear_buffer();

    if (wp->state == WAV_IDLE || wp->state == WAV_ERROR)
    {
    	ssd1306_print(16, 52, "INSERT DISC");

        // Isometric jukebox "block" -- wireframe cube: 6 outer edges plus
		// 3 internal edges from the center to alternating vertices, the
		// classic way to fake 3 visible faces on a monochrome display
		// without needing a raster bitmap. Small circle on the top face
		// stands in for the record/disc slot.
		const int cx = 64, cy = 34, s = 10;
		const int top[2]    = {cx,        cy - s};
		const int rTop[2]   = {cx + 9,    cy - s/2};
		const int rBot[2]   = {cx + 9,    cy + s/2};
		const int bot[2]    = {cx,        cy + s};
		const int lBot[2]   = {cx - 9,    cy + s/2};
		const int lTop[2]   = {cx - 9,    cy - s/2};
		const int center[2] = {cx, cy};

		ssd1306_draw_line(top[0], top[1], rTop[0], rTop[1]);
		ssd1306_draw_line(rTop[0], rTop[1], rBot[0], rBot[1]);
		ssd1306_draw_line(rBot[0], rBot[1], bot[0], bot[1]);
		ssd1306_draw_line(bot[0], bot[1], lBot[0], lBot[1]);
		ssd1306_draw_line(lBot[0], lBot[1], lTop[0], lTop[1]);
		ssd1306_draw_line(lTop[0], lTop[1], top[0], top[1]);
		ssd1306_draw_line(center[0], center[1], bot[0], bot[1]);
		ssd1306_draw_line(center[0], center[1], rTop[0], rTop[1]);
		ssd1306_draw_line(center[0], center[1], lTop[0], lTop[1]);
		ssd1306_draw_circle(cx, cy - s/2, 2); // record slot on the top face

		// Flashing arrow above it, pointing down -- only drawn on the
		// "on" half of arrowBlinkOn's 2Hz toggle (set in the TIM2 ISR)
		// Plus music notes after "INSERT DISC"
		if (arrowBlinkOn)
		{
			ssd1306_draw_line(cx, 5, cx, 15);        // shaft
			ssd1306_draw_line(cx, 18, cx - 4, 15);   // left head
			ssd1306_draw_line(cx, 18, cx + 4, 15);   // right head

			ssd1306_print(85, 52, "[][]");
		}
		else {
			ssd1306_print(85, 52, "][][");
		}
    }
    else
    {
        // Song title
    	char titleLine[40];
    	snprintf(titleLine, sizeof(titleLine), "%s.OGG", wp->title);
    	ssd1306_print(4, 4, titleLine);

        // Progress bar (0-255 fraction scaled to a 100px track)
        uint8_t frac = WavPlayer_GetProgressFraction(wp);
        uint8_t barWidth = (uint8_t)(((uint16_t)frac * 100) / 255);
        ssd1306_draw_rect(10, 22, 104, 10);
        ssd1306_filled_rect(12, 24, barWidth, 6);

        // Volume bar (0-100%, increments of 5%)
		ssd1306_draw_rect(10, 56, 104, 6);
		ssd1306_filled_rect(11, 57, (uint8_t)((uint32_t)volumePercent * 102 / 100), 4);

        // Elapsed / total time
        char timeStr[20];
        uint32_t elapsed = WavPlayer_GetElapsedSeconds(wp);
        uint32_t total = WavPlayer_GetTotalSeconds(wp);
        snprintf(timeStr, sizeof(timeStr), "%02lu:%02lu  %02lu:%02lu",
                 elapsed / 60, elapsed % 60, total / 60, total % 60);
        ssd1306_print(10, 36, timeStr);

        if (wp->state == WAV_PAUSED) ssd1306_print(10, 48, "PAUSED");
    }

    ssd1306_update(); // RN : NOT non-blocking, DMA-driven
}

/* USER CODE END 4 */
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
