jonbackflip/STM32-RFID-Based-Minecraft-Jukebox/Jukebox_STM32CubeIDE_Files/Core/Inc/main.h

#define Disc_Insertion_BTN_Pin GPIO_PIN_1
#define Disc_Insertion_BTN_GPIO_Port GPIOA
#define Disc_Insertion_BTN_EXTI_IRQn EXTI1_IRQn
#define PAUSE_BTN_Pin GPIO_PIN_1
#define PAUSE_BTN_GPIO_Port GPIOB
#define SPEAKER_ENABLE_Pin GPIO_PIN_10
#define SPEAKER_ENABLE_GPIO_Port GPIOB
#define HEADPHONE_JACK_DETECT_Pin GPIO_PIN_12
#define HEADPHONE_JACK_DETECT_GPIO_Port GPIOB
#define SD_DETECT_Pin GPIO_PIN_14
#define SD_DETECT_GPIO_Port GPIOB
#define CS_Pin GPIO_PIN_11
#define CS_GPIO_Port GPIOA
#define RESET_Pin GPIO_PIN_15
#define RESET_GPIO_Port GPIOA
