jonbackflip/STM32-RFID-Based-Minecraft-Jukebox/Jukebox_STM32CubeIDE_Files/Core/Inc/MFRC522_STM32.h

#ifndef MFRC522_STM32_MIN_H
#define MFRC522_STM32_MIN_H

#include "stm32f4xx_hal.h"
#include <stdint.h>
#include <stdio.h>

#define ENABLE_USER_LOG   1
#define ENABLE_DEBUG_LOG  0 // Test with this disabled

#if ENABLE_USER_LOG
  #define USER_LOG(fmt, ...) printf("[USER] " fmt "\r\n", ##__VA_ARGS__)
#else
  #define USER_LOG(fmt, ...)
#endif

#if ENABLE_DEBUG_LOG
  #define DEBUG_LOG(fmt, ...) printf("[DEBUG] " fmt "\r\n", ##__VA_ARGS__)
#else
  #define DEBUG_LOG(fmt, ...)
#endif

// Essential registers
#define PCD_CommandReg     0x01
#define PCD_ComIrqReg      0x04
#define PCD_ErrorReg       0x06
#define PCD_Status2Reg     0x08
#define PCD_FIFODataReg    0x09
#define PCD_FIFOLevelReg   0x0A
#define PCD_BitFramingReg  0x0D
#define PCD_TxControlReg   0x14
#define PCD_TxAutoReg      0x15
#define PCD_RFCfgReg       0x26
#define PCD_TModeReg       0x2A
#define PCD_TPrescalerReg  0x2B
#define PCD_TReloadRegL    0x2C
#define PCD_TReloadRegH    0x2D
#define PCD_DemodReg       0x19
#define PCD_VersionReg     0x37

// Commands
#define PCD_Idle           0x00
#define PCD_Transceive     0x0C
#define PCD_SoftReset      0x0F

// PICC commands
#define PICC_REQA          0x26
#define PICC_SEL_CL1       0x93

// Status
#define STATUS_OK          0
#define STATUS_ERROR       1
#define STATUS_TIMEOUT     2

typedef struct {
    SPI_HandleTypeDef *hspi;
    GPIO_TypeDef *csPort;
    uint16_t csPin;
    GPIO_TypeDef *rstPort;
    uint16_t rstPin;
} MFRC522_t;

// Prototypes
void MFRC522_Init(MFRC522_t *dev);
void MFRC522_AntennaOff(MFRC522_t *dev);
void MFRC522_AntennaOn(MFRC522_t *dev);
uint8_t MFRC522_ReadReg(MFRC522_t *dev, uint8_t reg);
void MFRC522_WriteReg(MFRC522_t *dev, uint8_t reg, uint8_t value);
void MFRC522_SetBitMask(MFRC522_t *dev, uint8_t reg, uint8_t mask);
void MFRC522_ClearBitMask(MFRC522_t *dev, uint8_t reg, uint8_t mask);
uint8_t MFRC522_RequestA(MFRC522_t *dev, uint8_t *atqa);
uint8_t MFRC522_Anticoll(MFRC522_t *dev, uint8_t *uid);
uint8_t MFRC522_ReadUid(MFRC522_t *dev, uint8_t *uid);
uint8_t waitcardRemoval (MFRC522_t *dev);
uint8_t waitcardDetect (MFRC522_t *dev);

#endif
