jonbackflip/STM32-RFID-Based-Minecraft-Jukebox/(commit log)

2026-09-12 Create PCB_Images
2026-09-12 Create PCB
    PCB layers and 3D views.
2026-10-03 RFID and OLED update
    RFID_Poll(...) now called every TIM1 interrupt.
    Added jukebox + flashing arrow animation for idle (no disc detected) state on OLED screen.
2026-10-04 the music disc update
    Added a couple more music discs
2026-10-05 the pcb update
    (mostly) finished routing, fill areas, edge cuts, and silkscreens
2026-10-05 the actual pcb update, ignore the other one
    the whole kicad project
    [MAX98367A Circuitry.kicad_sch, MFRC522 Circuitry.kicad_sch, PCM5102A & HT97226 Circuitry.kicad_sch, Power Flags & Testing Pads.kicad_sch, Rotary Encoder Circuitry.kicad_sch, SD Card Circuitry.kicad_sch, SSD1306 OLED Circuitry.kicad_sch, STM32F411 Circuitry.kicad_sch]
2026-10-05 new pcb. added power switch and disc detect button
    rfid reading has been unreliable, so added a button that gets pressed when a disc is inserted to lock the current disc that's playing. eliminates the chance of a music disc that's inserted to randomly stop playing due to the rfid reader's wonky detection not catching its presence
    [STM32F411 Circuitry.kicad_sch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]
2026-10-05 updated pcb images
