jonbackflip/STM32-RFID-Based-Minecraft-Jukebox/(notices)

Notices in the files:
Jukebox_STM32CubeIDE_Files/Core/Inc/main.h:
Copyright (c) 2026 STMicroelectronics.
All rights reserved.
This software is licensed under terms that can be found in the LICENSE file
